Justinl71/Capstone_RainMonitoringSystem/FinalPoster_Team260.pdf

RESEARCH POSTER PRESENTATION TEMPLATE © 2019
www.PosterPresentations.com

Figure 7: Rainwater Data Collection Node

Our current prototype system consists of 3 data

collection nodes and 1 gateway node. The diagram

below displays the architecture of our system.

Figure 1: All 3 Assembled Data Collection Nodes

Over 20 million residents of Mexico City have

some form of trouble accessing clean drinking water.

Mexico City has depleted underground aquifers which

cannot be replenished at the same rate as consumption.

The Mexican government has tried to alleviate the

problem by trucking water into neighborhoods.This

solution is not scalable and cost ineffective.

# Designing a rainwater monitoring system to combat water scarcity in the slums of Mexico City

# Jeremy Lee, Justin Leung, Yongrui Zhang

University of Toronto, The Edward S. Rogers Sr. Department of Electrical and Computer Engineering

## Majority of Mexico City populace lack access to clean water

## System Component: Gateway

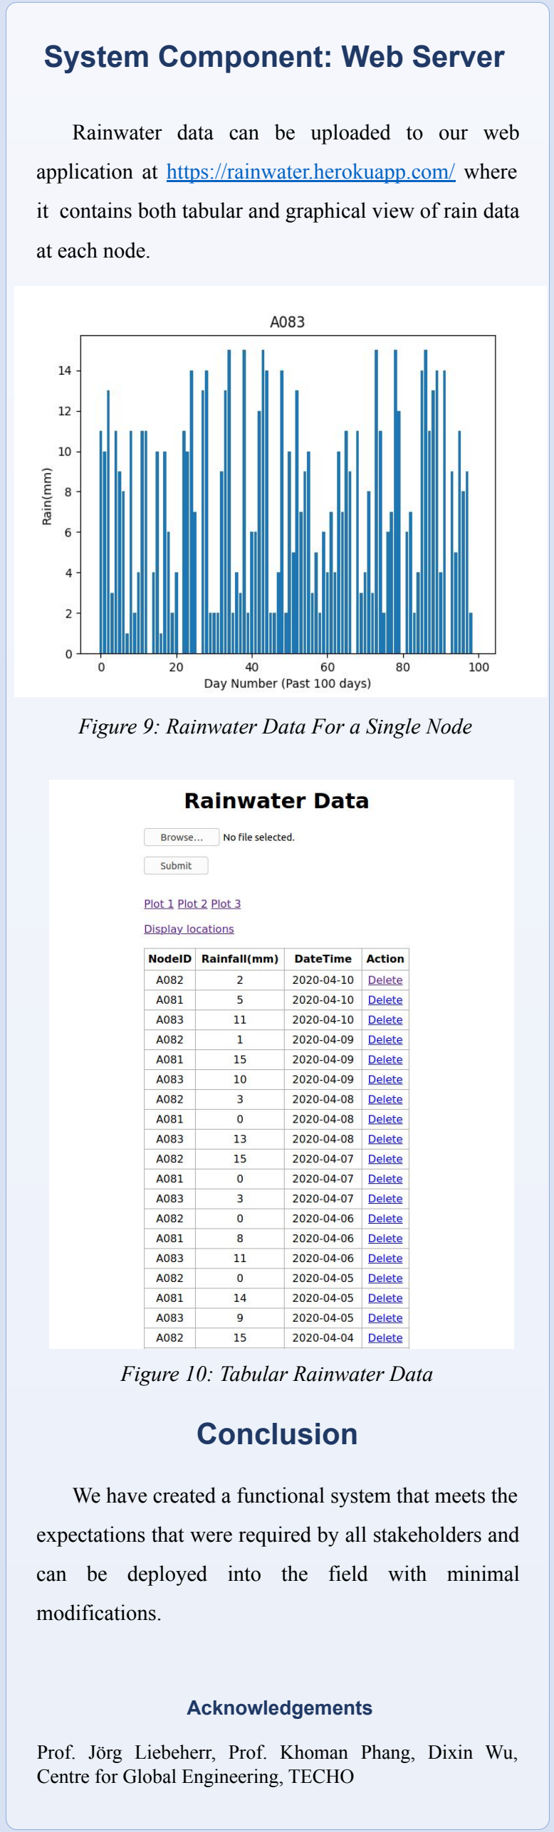
[picture p3: figure]
Conclusion; Acknowledgements; Centre for Global Engineering, TECHO; System Component: Web Server; Figure 10: Tabular Rainwater Data; application at; https://rainwater.herokuapp.com/; where; at each node.; modifications.

Prof. Jörg Liebeherr, Prof. Khoman Phang, Dixin Wu,

Supervisor: Jörg Liebeherr Administrator: Khoman Phang Team #260
Section 2

Figure 1: Mexico City’s Initiative to Truck Water From Nearby Lakes Source:
https://penniur.upenn.edu/uploads/media/02_Gutierrez.pdf.
High accuracy, long range | System Component: Node

## System design

Using | the | cottonCandy | library | and | LoRa

technology, we are able to transmit data across

different nodes at a transmission radius up to 10

kilometres. In conjunction with an accurate tipping

bucket rain gauge capable of measuring to the nearest

0.3mm, we have created a high accuracy, long range

system.

Our goal is to create a rainwater monitoring

system consisting of different nodes, where each node

is responsible for measuring the precipitation data for a

given area. We have developed 3 node prototypes, with

one additional central gateway prototype where data is

centralized and stored.

Figure 2: LoRa Performance versus other communication methods Source:
https://www.semtech.com/lora

## Creating a Novel System to Measure Precipitation

## System component: External attachments

Figure 4: Tipping bucket rain gauge
Source:
https://duino4projects.com/arduino-weather-station-part3-rain/

Figure 5: Adalogger FeatherWing RTC + SD Add-on

Figure 6: 900 mAh Li-Poly Battery

Figure 8: Rainwater Data Collection Gateway

Figure 9: Rainwater Data For a Single Node

Figure 3 - System Block Diagram

A 900 mAh Li-Poly battery is required to power

the system for a 2 month period.

The Adalogger Featherwing contains the RTC and

microSD card required for deep sleep and data storage.

The tipping bucket rain gauge measures rainfall to

a 0.3mm accuracy.

The | rain | gauge, | battery, | and | Adalogger

Featherwing are attached to the node. The node will

toggle between sleep and transmission states every 24

hours. During the 10 minute transmittance period,

rainwater data measured by the rain gauge is sent to

the gateway via LoRa radio.

The gateway initiates a request to every node in

the spanning tree network to collect rainwater data.

After each reply is received, the data is stored onto the

gateway’s microSD card. The gateway will also

coordinate the next transmission time to each node.

The node is toggled between sleep and

transmission states by the RTC through the use of

interrupts. The rain data is also incremented through

interrupts made by the rain gauge.

Rainwater data can be uploaded to our web

it contains both tabular and graphical view of rain data

We have created a functional system that meets the

expectations that were required by all stakeholders and

can be deployed into the field with minimal
