Justinl71/Capstone_RainMonitoringSystem/RainDataCollection/ForwardEngine.cpp

/*	  
	Copyright 2020, Network Research Lab at the University of Toronto.
	This file is part of CottonCandy.
	CottonCandy is free software: you can redistribute it and/or modify
	it under the terms of the GNU Lesser General Public License as published by
	the Free Software Foundation, either version 3 of the License, or
	(at your option) any later version.
	CottonCandy is distributed in the hope that it will be useful,
	but WITHOUT ANY WARRANTY; without even the implied warranty of
	MERCHANTABILITY or FITNESS FOR A PARTICULAR PURPOSE.  See the
	GNU Lesser General Public License for more details.
	You should have received a copy of the GNU Lesser General Public License
	along with CottonCandy.	 If not, see <https://www.gnu.org/licenses/>.
*/

#include "ForwardEngine.h"
#include "LowPower.h"
#include "RTClib.h"
#include <string.h>
#define RAIN_GAUGE 1
#include <LoRa.h>


volatile bool allowReceiving = false;
volatile int immediateInterruptPreventer = 0;
const int myRTCInterruptPin = 0;
RTC_PCF8523 adalogger_rtc;

//this is being used rn
unsigned long sleepTime = 60;//seconds
unsigned long awakeTime = 60;//seconds
unsigned long receivingPeriod; 

bool firstGatewayContact = false;
void rtcISR();

ForwardEngine::ForwardEngine(byte *addr, DeviceDriver *driver)
{
	myAddr[0] = addr[0];
	myAddr[1] = addr[1];

	myDriver = driver;

	//A node is its own parent initially
	memcpy(myParent.parentAddr, myAddr, 2);
	myParent.hopsToGateway = 255;

	numChildren = 0;
	childrenList = nullptr;

	//Here we will set the random seed to analogRead(A0)
	//The node address can also be used. Interesting to find out if it is better
	//unsigned long seed = myAddr[0] << 8 + myAddr[1];

	//Note: To obtain an arbitary seed, make sure Pin A0 is not connected to anything
	randomSeed(analogRead(A0));
}

ForwardEngine::~ForwardEngine()
{
	//TODO: need to do some clean up here

	ChildNode *iter = childrenList;
	while (iter != nullptr)
	{
		ChildNode *temp = iter;

		iter = temp->next;
		delete temp;
	}
}

void ForwardEngine::setAddr(byte *addr)
{
	memcpy(myAddr, addr, 2);
}

byte *ForwardEngine::getMyAddr()
{
	return this->myAddr;
}

byte *ForwardEngine::getParentAddr()
{
	return this->myParent.parentAddr;
}

void ForwardEngine::setGatewayReqTime(unsigned long gatewayReqTime)
{
	this->gatewayReqTime = gatewayReqTime;
}

unsigned long ForwardEngine::getGatewayReqTime()
{
	return this->gatewayReqTime;
}

void ForwardEngine::onReceiveRequest(void (*callback)(byte **, byte *))
{
	this->onRecvRequest = callback;
}
void ForwardEngine::onReceiveResponse(void (*callback)(byte *, byte, byte *))
{
	this->onRecvResponse = callback;
}

/**
 * The join function is responsible for sending out a beacon to discover neighboring 
 * nodes. After sending out the beacon, the node will receive messages for a given
 * period of time. Since the node might receive multiple replies of its beacon, as well
 * as the beacons from other nearby nodes, it waits for a period of time to collect info
 * from the nearby neighbors, and pick the best parent using the replies received.
 * 
 * Returns: True if the node has joined a parent
 */
bool ForwardEngine::join()
{
	if (state != INIT)
	{
		//The node has already joined a network
		return true;
	}

	GenericMessage *msg = nullptr;

	ParentInfo bestParentCandidate = myParent;

	//Serial.print("myAddr = 0x");
	//Serial.print(myAddr[0], HEX);
	//Serial.println(myAddr[1], HEX);
	Join beacon(myAddr, BROADCAST_ADDR);

	//Send out the beacon once to discover nearby nodes
	beacon.send(myDriver, BROADCAST_ADDR);

	//Give some time for the transimission and replying
	//sleepForMillis(500);

	//Serial.print("Wait for reply: timeout = ");
	//Serial.println(DISCOVERY_TIMEOUT);

	unsigned long previousTime = getTimeMillis();

	/** 
	 * In this loop, for a period of DISCOVERY_TIME, the node will wait for the following types 
	 * of incoming messages:
	 *			1. Beacon ACK (sent by a potential parent)
	 *			4. For any other types of message, the node will discard them
	 * 
	 * It is possible that the node did not receive any above messages at all. In this case, the
	 * loop will timeout after a period of DISCOVERY_TIMEOUT. 
	 */
	while ((unsigned long)(getTimeMillis() - previousTime) < DISCOVERY_TIMEOUT)
	{

		//Now try to receive the message
		msg = receiveMessage(myDriver, RECEIVE_TIMEOUT);

		if (msg == nullptr)
		{
			//If no message has been received
			continue;
		}

		byte *nodeAddr = msg->srcAddr;
		// Serial.print("Received msg type = ");
		// Serial.println(msg->type);
		switch (msg->type)
		{
		case MESSAGE_JOIN_ACK:
		{
			Serial.print(F("MESSAGE_JOIN_ACK: src=0x"));
			Serial.print(nodeAddr[0], HEX);
			Serial.print(nodeAddr[1], HEX);
			Serial.print(" rssi=");
			Serial.println(msg->rssi, DEC);

			//If it receives an ACK sent by a potential parent, compare with the current parent candidate
			byte newHopsToGateway = ((JoinAck *)msg)->hopsToGateway;

			if (newHopsToGateway != 255)
			{
				//The remote node has a connection to the gateway
				if (bestParentCandidate.hopsToGateway != 255)
				{
					//Case 1: Both the current parent candidate and new node are connected to the gateway
					//Choose the candidate with the minimum hops to the gateway while the RSSI is over the threshold
					//If the hop counts are the same, pick the one with the best signal strength
					if (msg->rssi >= RSSI_THRESHOLD)
					{
						if (newHopsToGateway < bestParentCandidate.hopsToGateway || (newHopsToGateway == bestParentCandidate.hopsToGateway && msg->rssi > bestParentCandidate.Rssi))
						{
							memcpy(bestParentCandidate.parentAddr, nodeAddr, 2);
							bestParentCandidate.hopsToGateway = newHopsToGateway;
							bestParentCandidate.Rssi = msg->rssi;

							Serial.println(F("This is a better parent"));
						}
					}
				}
				else
				{
					//Case 2: Only the new node is connected to the gateway
					//We always favor the candidate with a connection to the gateway
					memcpy(bestParentCandidate.parentAddr, nodeAddr, 2);
					bestParentCandidate.hopsToGateway = newHopsToGateway;
					bestParentCandidate.Rssi = msg->rssi;
					Serial.println(F("This is the first new parent"));
				}
			}
			else
			{
				Serial.println(F("The node does not have a path to gateway. Discard"));
			}
			//This case is currently ignored
			/*
				else if (bestParentCandidate.hopsToGateway == -1){
					//Case 3: Both the current and new parent candidates does not have a connection to the gateway
					//Compare the node address. The smaller node address should be the parent (gateway address is always larger than regular node address)
					if(nodeAddr < bestParentCandidate.parentAddr){
						bestParentCandidate.parentAddr = nodeAddr;
						bestParentCandidate.hopsToGateway = newHopsToGateway;
						bestParentCandidate.Rssi = newRssi;
					}
				}
				*/

			//Other cases involve: new node -> not connected to gateway, current best parent -> connected to the gateway
			//In this case we will not update the best parent candidate
			break;
		}
		default:
			//Serial.print("MESSAGE: type=");
			//Serial.print(msg->type, HEX);
			//Serial.print(" src=0x");
			//Serial.println(nodeAddr, HEX);
			break;
		}

		delete msg;
	}

	Serial.println("Discovery timeout");

	if (bestParentCandidate.parentAddr[0] != myAddr[0] || bestParentCandidate.parentAddr[1] != myAddr[1])
	{
		//New parent has found
		Serial.print(F("bestParentCandidate.parentAddr = 0x"));
		Serial.print(bestParentCandidate.parentAddr[0], HEX);
		Serial.println(bestParentCandidate.parentAddr[1], HEX);

		myParent = bestParentCandidate;

		hopsToGateway = bestParentCandidate.hopsToGateway + 0b1;

		Serial.print(F(" HopsToGateway = "));
		Serial.println(hopsToGateway);

		Serial.println(F("Send JoinCFM to parent"));
		//Send a confirmation to the parent node
		JoinCFM cfm(myAddr, myParent.parentAddr, numChildren);

		cfm.send(myDriver, myParent.parentAddr);

		//Assign the alive timestamp to the parent
		myParent.lastAliveTime = getTimeMillis();

		myParent.requireChecking = false;

		return true;
	}
	else
	{
		return false;
	}
}

bool ForwardEngine::run()
{
	  
	//If the node is a gateway, it does not have to join the network to operate
	//Gateway is distinguished by the highest bit = 1
	if (myAddr[0] & GATEWAY_ADDRESS_MASK)
	{
		state = JOINED;

		//Gateway has the cost of 0
		hopsToGateway = 0;
	}
	else
	{
		state = INIT;

		//Uninitilized gateway cost
		hopsToGateway = 255;

		//If it is a regular node, it needs to join the network to operate
		while (state == INIT)
		{
			if (join())
			{
				state = JOINED;
			}
			else
			{
				Serial.println(F("Joining unsuccessful. Retry joining in 5 seconds"));
				sleepForMillis(5000);
			}
		}
	}

	Serial.println(F("Joining successful"));

	//bool checkingParent = false;
	unsigned long checkingStartTime = 0;

	// the request time starts when Gateway is up
	lastReqTime = getTimeMillis();

	GenericMessage *msg = nullptr;

	//The core network operations are carried out here
	while (state == JOINED)
	{

		if (!allowReceiving && firstGatewayContact)
		{
			
			// Set alarm
			detachInterrupt(digitalPinToInterrupt(myRTCInterruptPin));
			delay(1000);
			Serial.print(F("adalogger_rtc sleeps for: "));
			Serial.println(sleepTime);
			adalogger_rtc.deconfigureAllTimers();
			adalogger_rtc.enableCountdownTimer(PCF8523_FrequencySecond, sleepTime-3);
			delay(100);
			USBCON |= _BV(FRZCLK);
			delay(100);
			PLLCSR &= ~_BV(PLLE);
			delay(100);
			USBCON &= ~_BV(USBE);
			delay(100);
			attachInterrupt(digitalPinToInterrupt(myRTCInterruptPin), rtcISR, FALLING);
			delay(100);
			
			allowReceiving = false; 
			
			// Sleep Radio
			LoRa.sleep();
			
			// Go to sleep until adalogger_rtc wakeup
			while(!allowReceiving){
				LowPower.powerDown(SLEEP_FOREVER, ADC_OFF, BOD_OFF);
				delay(100);
			}
			
			// Wake up 
			LoRa.receive();
			USBDevice.attach();
			delay(100);
			detachInterrupt(digitalPinToInterrupt(myRTCInterruptPin));
			delay(100);
			// Just to make sure allowReceiving is set to true
			
			if (!allowReceiving)
			{
				allowReceiving = true;
			}
				
			//Now the MCU has woken up, wait a while for the system to fully start up
			delay(100);
			Serial.print(F("adalogger_rtc receiving for: "));
			Serial.println(awakeTime);
			delay(100);
			//Set up the alarm for the end of the receiving period
			adalogger_rtc.deconfigureAllTimers();
			adalogger_rtc.enableCountdownTimer(PCF8523_FrequencySecond, awakeTime); //15 seconds
			attachInterrupt(digitalPinToInterrupt(myRTCInterruptPin), rtcISR, FALLING);
			delay(100);
			// Just to make sure allowReceiving is set to true
			delay(100);
			if (!allowReceiving)
			{
				allowReceiving = true;
			}
		}
		msg = receiveMessage(myDriver, RECEIVE_TIMEOUT);

		if (msg != nullptr)
		{

			byte *nodeAddr = msg->srcAddr;

			//Based on the received message, do the corresponding actions
			switch (msg->type)
			{
			case MESSAGE_JOIN:
			{
				//If a join message comes from the parent node, it suggests that the parent node has
				//disconnected from the gateway, do not reply back with a JoinACK
				if (msg->srcAddr[0] == myParent.parentAddr[0] && msg->srcAddr[1] == myParent.parentAddr[1])
				{
					Serial.println(F("Parent node has disconnected from the gateway"));
				}
				else
				{
					/*
					//DEBUG code for testing: For gateway only accept node 0xA0 and 0xA1
					if (myAddr[0] & GATEWAY_ADDRESS_MASK)
					{
						if (msg->srcAddr[1] > 0xA1)
						{
							break;
						}
					}
					*/

					JoinAck ack(myAddr, nodeAddr, hopsToGateway);

					// Introduce some random time backoff to prevent collision
					// From our experiments, we noticed packet losses when multiple nodes send joinACK instantly
					// upon receiving a join message. This cause some packets to go missing (Even LBT in EBYTE can
					// not help since the sending happened at almost the same time)

					long backoff = random(MIN_BACKOFF_TIME, MAX_JOIN_ACK_BACKOFF_TIME);

					Serial.print(F("Sleep for some time before sending JoinAck: "));
					Serial.println(backoff);

					sleepForMillis(backoff);

					ack.send(myDriver, nodeAddr);

					Serial.print(F("MESSAGE_JOIN: src=0x"));
					Serial.print(nodeAddr[0], HEX);
					Serial.println(nodeAddr[1], HEX);
				}

				break;
			}
			case MESSAGE_JOIN_CFM:
			{
				ChildNode *iter = childrenList;

				while (iter != nullptr){
					if(iter->nodeAddr[0] == msg->srcAddr[0] && iter->nodeAddr[1] == msg->srcAddr[1]){
						break;
					}
					iter = iter->next;
				}
				// If the child node has already been in the children list (i.e. it reconnects to this
				// parent node), do not add it to the list
				if (iter != nullptr){
					break;
				}
				//Add the new child to the linked list (Insert at the beginning of the linked list)

				ChildNode *node = new ChildNode();
				node->nodeAddr[0] = msg->srcAddr[0];
				node->nodeAddr[1] = msg->srcAddr[1];

				node->next = childrenList;

				childrenList = node;

				numChildren++;

				Serial.print(F("A new child has joined: 0x"));
				Serial.print(nodeAddr[0], HEX);
				Serial.println(nodeAddr[1], HEX);
				break;
			}
			//Dixin update: we will replace the "Aliveness checking" with the GatewayReq
			/*
			case MESSAGE_REPLY_ALIVE:
			{
				//We do not need to check the message src address here since the parent should
				//only unicast the reply message (Driver does the filtering).
				Serial.println(F("ReplyAlive from parent"));
				//If we have previously issued a checkAlive message
				if (myParent.requireChecking)
				{
					//The parent node is proven to be alive
					myParent.requireChecking = false;
					//Update the last time we confirmed when the parent node was alive
					myParent.lastAliveTime = getTimeMillis();
				}
				break;
			}
			case MESSAGE_CHECK_ALIVE:
			{
				//Parent replies back to the child node
				Serial.println("I got checked by my child node");
				ReplyAlive reply(myAddr, nodeAddr);
				reply.send(myDriver, nodeAddr);
				break;
			}
			*/
			case MESSAGE_GATEWAY_REQ:
			{

				//Dixin Wu update: if we broadcast the gatewayReq, we should only accept REQ from the parent
				if (msg->srcAddr[0] != myParent.parentAddr[0] || msg->srcAddr[1] != myParent.parentAddr[1])
				{
					//If the message does not come from the parent node
					Serial.println(F("Req is not received from parent. Ignore."));
					break;
				}

				//This shouldn't happen, but in case gateway should ignore this message
				if (myAddr[0] & GATEWAY_ADDRESS_MASK)
				{
					break;
				}
				else
				{
					
					// we know our parent is alive
					myParent.requireChecking = false;
					myParent.lastAliveTime = getTimeMillis();

					maxBackoffTime = ((GatewayRequest *)msg)->childBackoffTime;
					Serial.print(F("New maximum backoff time: "));
					Serial.println(maxBackoffTime);

					// backoff to avoid collision
					unsigned long backoff = random(MIN_BACKOFF_TIME, maxBackoffTime);
					Serial.print(F("Sleep for some time before replying back: "));
					Serial.println(backoff);

					sleepForMillis(backoff);

					// Use callback to get node data
					byte *nodeData = new byte[MAX_LEN_DATA_NODE_REPLY]; //magic number 64 comes from MP comment
					byte dataLength;
					if (onRecvRequest)
						onRecvRequest(&nodeData, &dataLength);

					// Dixin update: First send reply to the parent
					NodeReply nReply(myAddr, myParent.parentAddr, ((GatewayRequest *)msg)->seqNum, dataLength, nodeData);
					nReply.send(myDriver, myParent.parentAddr);

					delete[] nodeData;

					// Dixin update: Get the expected time for the next gateway request
					gatewayReqTime = ((GatewayRequest *)msg)->nextReqTime;
					Serial.print(F("Next req will be in "));
					Serial.println(gatewayReqTime);

					if (numChildren > 0)
					{
						// Dixin update: Other children of the parent will finish transmitting after 3 seconds, so it is better to
						// wait until all of them finished transmitting before forwarding the messages
						unsigned long remainingTime = maxBackoffTime - backoff;
						backoff = random(remainingTime, remainingTime + maxBackoffTime);
						sleepForMillis(backoff);

						unsigned long childBackoffTime = numChildren * MAX_BACKOFF_TIME_FOR_ONE_CHILD;

						if (childBackoffTime > gatewayReqTime)
						{
							childBackoffTime = gatewayReqTime;
						}

						Serial.print(F("Max backoff time for child nodes: "));
						Serial.println(childBackoffTime);

						//Dixin Wu update: We simply broadcast the gatewayReq
						GatewayRequest gwReq(myAddr, BROADCAST_ADDR, ((GatewayRequest *)msg)->seqNum, gatewayReqTime, childBackoffTime);
						gwReq.send(myDriver, BROADCAST_ADDR);
					}
					
					
					/*
					* For less frequent data gathering every 20 minutes or more (e.g. every hours), only receive for 10 minutes
					* For more frequent data gathering every 20 minutes or less (e.g. every 5 minutes), receive for 50% of the request interval
					*/
						
					if (gatewayReqTime <= 1200e3)
					{
						receivingPeriod = gatewayReqTime / 1e3 / 2;
					}
					else
					{
						receivingPeriod = 600;
					}
					//receiving period, time that node needs to stay for is awakeTime
					//so set awake time equal to this
					sleepTime = (gatewayReqTime / 1e3) -  receivingPeriod;
					awakeTime = receivingPeriod;
					if (awakeTime <= 0 || awakeTime > 600){
						awakeTime = 78;
					}
					
					if (sleepTime <= 0 || sleepTime > 600){
						sleepTime = 78;
					}
					
					Serial.println(F("Receiving period: "));
					Serial.println(awakeTime);
					Serial.println(F("Sleep period: "));
					Serial.println(sleepTime);
					
					if (!firstGatewayContact)
					{
						delay(100);
						Serial.println(F("First time gateway REQ"));
						delay(100);
						// the first request has been received from the gateway
						firstGatewayContact = true;
						//Set receiving flag to be true
						allowReceiving = true;
						
						delay(100);
						Serial.println(F("First time setting RTC alarm"));
						delay(100);
						//Set up the alarm for the end of the receiving period
						adalogger_rtc.deconfigureAllTimers();
						adalogger_rtc.enableCountdownTimer(PCF8523_FrequencySecond, awakeTime); 
						attachInterrupt(digitalPinToInterrupt(myRTCInterruptPin), rtcISR, FALLING);
						delay(100);
						// Just to make sure allowReceiving is set to true
						delay(100);
					}
				}
				break;
			}
			case MESSAGE_NODE_REPLY:
			{
				// Gateway should handle this
				if (myAddr[0] & GATEWAY_ADDRESS_MASK)
				{
					// Should be what gateway is waiting for
					if (((NodeReply *)msg)->seqNum != seqNum)
					{
						Serial.print(F("Warning: Gateway got wrong seqNum: "));
						Serial.print(((NodeReply *)msg)->seqNum);
						Serial.print(F("  It should be: "));
						Serial.println(seqNum);
					}

					// Gateway should use a callback to process the data
					Serial.print(F("Node Reply Sequence number: "));
					Serial.println(((NodeReply *)msg)->seqNum);
					if (onRecvResponse)
						onRecvResponse(((NodeReply *)msg)->data, ((NodeReply *)msg)->dataLength, ((NodeReply *)msg)->srcAddr);
				}
				// Node should forward this up to its parent
				else
				{
					//TODO: Dixin update -> should delay a bit here instead of sending immediately
					NodeReply nReply(msg->srcAddr, myParent.parentAddr, ((NodeReply *)msg)->seqNum, ((NodeReply *)msg)->dataLength, ((NodeReply *)msg)->data);

					// backoff to avoid collision
					long backoff = random(MIN_BACKOFF_TIME, maxBackoffTime);
					Serial.print(F("Sleep for some time before forwarding: "));
					Serial.println(backoff);
					sleepForMillis(backoff);

					nReply.send(myDriver, myParent.parentAddr);
				}
				break;
			}
			}

			delete msg;
		}

		unsigned long currentTime = getTimeMillis();
		//The gateway does not need to check its parent
		if (myAddr[0] & GATEWAY_ADDRESS_MASK)
		{
			/*
			// prepare to send out request
			if (gatewayReqTime == 0)
			{
				Serial.println("Gateway reqtime is 0 (not set)");
				continue;
			}
			*/
			if ((unsigned long)(currentTime - lastReqTime) >= gatewayReqTime)
			{
				// request data from all children
				seqNum += 1;
				lastReqTime = currentTime;

				unsigned long childBackoffTime = numChildren * MAX_BACKOFF_TIME_FOR_ONE_CHILD;

				/** If there are many child nodes and the time interval between requests are much
				 * less than the child backoff time calculated, this can result into asynchronous
				 * requests and replies (e.g. Replies with seq number 5 arrives after request with
				 * seq number 10 has been issued)
				 * 
				 * Thus, if the child backoff time is greater than the gateway request time interval,
				 * the backoff time will be at least set to the gateway request time interval. Note
				 * that the asynchronous replies and requests can still occur as the tree has multiple
				 * hierarchies, but hopefully it prevents some extreme cases where the calculated
				 * backoff time is multiple times of the gatewayReqTime.
				 * 
				 * In practice, the problem hardly occurs as the gatewayReqTime is usually set to hours
				 * and there are not so many nodes connected to the gateway. 
				 */
				if (childBackoffTime > gatewayReqTime)
				{
					childBackoffTime = gatewayReqTime;
				}

				Serial.print(F("Now Gateway sends out request: SeqNum="));
				Serial.print(seqNum);
				Serial.print(F(", Next Request Time="));
				Serial.print(gatewayReqTime);
				Serial.print(F(", Child Backoff Time="));
				Serial.println(childBackoffTime);

				//Dixin Wu update: what if we simply broadcast the gatewayReq
				GatewayRequest gwReq(myAddr, BROADCAST_ADDR, seqNum, gatewayReqTime, childBackoffTime);
				gwReq.send(myDriver, BROADCAST_ADDR);
			}
		}
		//For regular nodes, check whether a gatewayReq has arrived during the expected time interval
		else if ((unsigned long)(currentTime - myParent.lastAliveTime) > NEXT_GATEWAY_REQ_TIME_TOLERANCE_FACTOR * gatewayReqTime)
		{
			//This means that the node has not received any gatewayReqs from its parent which it should has received if the connection is still up

			state = INIT;
			Serial.println(F("No message has been received for the time period"));
		}

		//Dixin update: we will replace the "Aliveness checking" with the GatewayReq
		/*
		//The parent is currently being checked (CheckAlive Message has been sent already), but the reply has not been received yet
		if (myParent.requireChecking)
		{
			//If the reply has not been received in 10 seonds
			if (currentTime - checkingStartTime >= CHECK_ALIVE_TIMEOUT)
			{
				state = INIT;
				Serial.println(F("CheckAlive Timeout"));
				//loop will break
			}
		}
		//If the parent is not being checked and has not been checked in the past 30 seconds, we might need to check the parent liveness
		else if ((unsigned long)(currentTime - myParent.lastAliveTime) >= checkAliveInterval)
		{
			Serial.println(F("Time to check parent"));
			myParent.requireChecking = true;
			//Send out the checkAlive message to the parent
			CheckAlive checkMsg(myAddr, myParent.parentAddr, 0);
			checkMsg.send(myDriver, myParent.parentAddr);
			//record the current time
			checkingStartTime = getTimeMillis();
			Serial.print(F("Checking start at "));
			Serial.println(checkingStartTime);
		}*/
	}

	//We have disconnected from the parent
	myParent.parentAddr[0] = myAddr[0];
	myParent.parentAddr[1] = myAddr[1];
	myParent.hopsToGateway = 255;

	return 1;
}
void rtcISR()
{
	if (immediateInterruptPreventer == 0){
		immediateInterruptPreventer++;
		return;
	}
	delay(100);
	Serial.println(F("Got interrupted"));
	delay(100);
	allowReceiving = !allowReceiving;
}
